cvra/CAN-USB-dongle/README.md

# CAN to USB adapter dongle

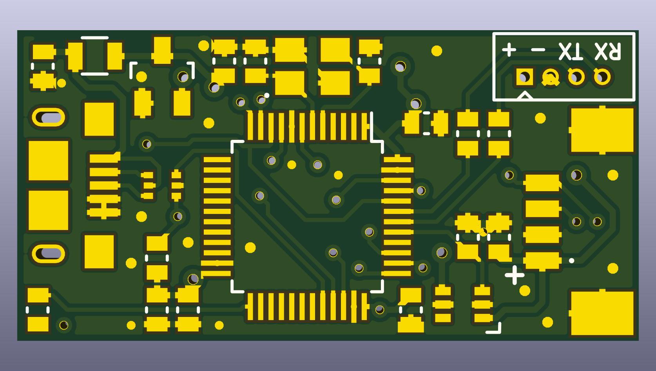
[picture p1: images/can-usb-dongle-front.jpg]
PCB front

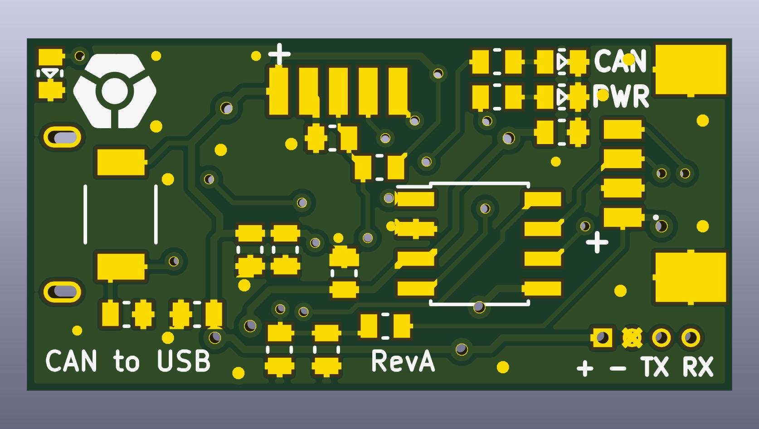
[picture p2: images/can-usb-dongle-back.jpg]
PCB back
