cvra/CAN-USB-dongle/BOM.ods

Total | 11.8679
number of boards | 7
Reference | Value | DigiKey part no. | QTY per board | Price (QTY=10) |  | QTY total | comment | Footprint
C2,C3,C4,C5,C9,C10,C13,C14,C16 | 100nF | 311-1088-1-ND | 9 | 0.0081 | 0.0729 | 63 |  | _std:_0603
C6 | 10nF | 311-1085-1-ND | 1 | 0.017 | 0.017 | 7 |  | _std:_0603
C7,C8 | 10pF | 399-1049-1-ND | 2 | 0.03 | 0.06 | 14 |  | _std:_0603
C11,C12,C15 | 1uF | 587-1242-1-ND | 3 | 0.041 | 0.123 | 21 |  | _std:_0603
C1 | 4.7uF | 311-1455-1-ND | 1 | 0.095 | 0.095 | 7 |  | _std:_0603
CONN1 | UART | WM1733-ND | 1 | 0.375 | 0.375 | 7 |  | _connectors:Molex-PicoBlade-4
CONN3 | MICRO_USB | 609-4616-1-ND | 1 | 0.386 | 0.386 | 7 |  | _connectors:_Micro-USB-AB-receptacle-SMT-th-no-slot
CONN4,CONN5 | CAN1 | WM7622CT-ND | 2 | 1.069 | 2.138 | 14 |  | _connectors:_Molex-PicoBlade-SMD-4
D1 | STATUS | 160-1436-1-ND | 1 | 0.24 | 0.24 | 7 | red | _std:_0603
D2 | CAN1 | 475-2831-1-ND | 1 | 0.35 | 0.35 | 7 | white | _std:_0603
D3 | V_BUS_PWR | 160-1435-1-ND | 1 | 0.24 | 0.24 | 7 | green | _std:_0603
F1 | Ih=500mA, It=1A | PICOSMDC050S-2CT-ND | 1 | 0.28 | 0.28 | 7 |  | Resistors_SMD:R_0805
R10,R11 | 100 | 311-100GRCT-ND | 2 | 0.008 | 0.016 | 14 |  | _std:_0603
R8 | 1.5k | 311-1.5KGRCT-ND | 1 | 0.011 | 0.011 | 7 |  | _std:_0603
R1,R2,R3,R4,R9 | 10k | 311-10.0KHRCT-ND | 5 | 0.01 | 0.05 | 35 |  | _std:_0603
R5 | 820 |  | 1 | 0.011 | 0.011 | 7 | STATUS | _std:_0603
R6 | 330 |  | 1 | 0.011 | 0.011 | 7 | CAN | _std:_0603
R7 | 680 |  | 1 | 0.011 | 0.011 | 7 | PWR | _std:_0603
SW1 | SW_PUSH | - | 1 | 0 | 0 | 7 | from ebay | _div:PushButtonSMD-5x3mm
U1 | STM32F302C8T | 497-14699-ND | 1 | 3.671 | 3.671 | 7 |  | Housings_QFP:LQFP-48_7x7mm_Pitch0.5mm
U2 | SN65HVD256 | 296-30093-1-ND | 1 | 1.276 | 1.276 | 7 |  | Housings_SOIC:SOIC-8_3.9x4.9mm_Pitch1.27mm
U3 | NUF2042XV6 | NUF2042XV6T1GOSCT-ND | 1 | 0.255 | 0.255 | 7 |  | _std:SOT-563_6-lead
U4 | MCP1700 | MCP1700T3302ETTCT-ND | 1 | 0.33 | 0.33 | 7 |  | Housings_SOT-23_SOT-143_TSOT-6:SOT-23
U5 | SiP32431 | SIP32431DR3-T1GE3CT-ND | 1 | 0.38 | 0.38 | 7 |  | Housings_SOT-23_SOT-143_TSOT-6:SC-70-6
X1 | 16MHz 10ppm | SER4069CT-ND | 1 | 0.469 | 0.469 | 7 |  | _div:_TSX-3225-SMD-XTAL
PCB | 2 layer 15x30mm |  | 1 | 1 | 1 | 7 |  | 10pcs à 10$ + shipping
Stencil |  |  | 1 | 0 | 0 | 7 |  | 10$ + shipping
