cvra/CAN-USB-dongle/can-usb-dongle-revC.pdf

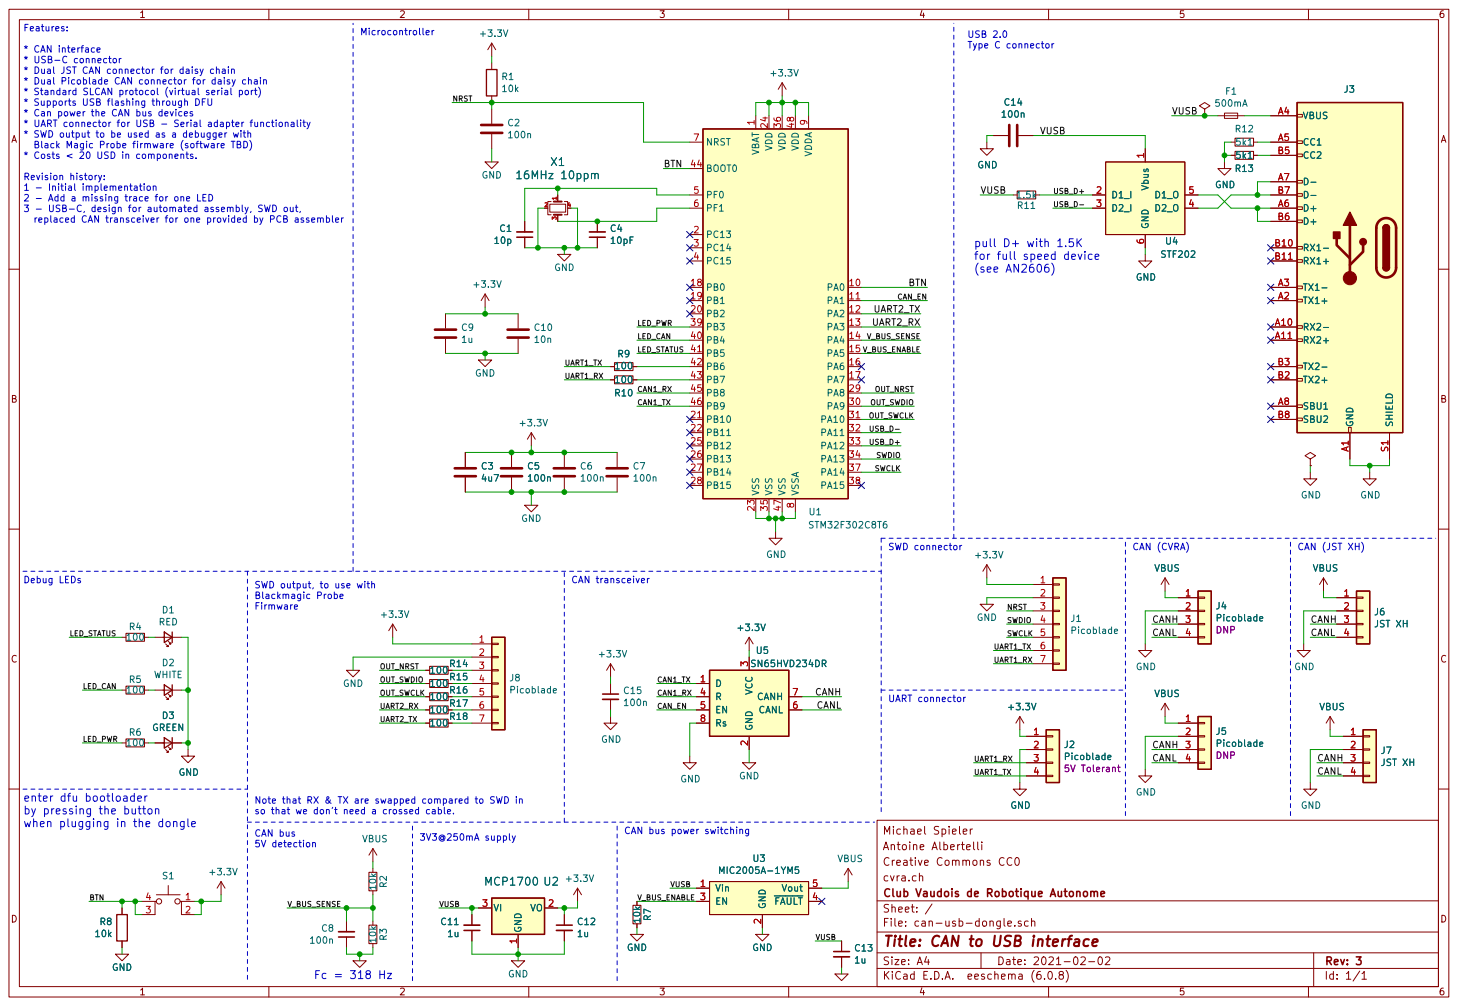
[picture p3: page 1]

* USB-C connector * Dual JST CAN connector for daisy chain

* Dual Picoblade CAN connector for daisy chain
* Standard SLCAN protocol (virtual serial port)
* Supports USB flashing through DFU
* Can power the CAN bus devices
* UART connector for USB - Serial adapter functionality
* SWD output to be used as a debugger with
Black Magic Probe firmware (software TBD)
* Costs < 20 USD in components.

1 PA0 10 PA1 11 PA2 12 PA3 13 PA4 14 PA5 15 PA6 16 PA7 17 PB0 18 PB1 19 PC13 2 PB2 20 PB10 21 PB11 22 VSS 23 VDD 24 PB12 25 PB13 26 PB14 27 PB15 28 PA8 29 PC14 3 PA9 30 PA10 31 PA11 32 PA12 33 PA13 34 VSS 35 VDD 36 PA14 37 PA15 38 PB3 39 PC15 4 PB4 40 PB5 41 PB6 42 PB7 43 BOOT0 44 PB8 45 PB9 46 VSS 47 VDD 48 PF0 5 PF1 6 NRST 7 VSSA

Revision history:
1 - Initial implementation
2 - Add a missing trace for one LED
3 - USB-C, design for automated assembly, SWD out,
replaced CAN transceiver for one provided by PCB assembler

for full speed device

Debug LEDs enter dfu bootloader by pressing the button

CAN (CVRA) CAN bus 5V detection SWD output, to use with

SWD connector Fc = 318 Hz

Note that RX & TX are swapped compared to SWD in

2 EN 3 ~{FAULT} 4 Vout 5 U3 MIC2005A-1YM5 GND

when plugging in the dongle

File: can-usb-dongle.sch Sheet: / Club Vaudois de Robotique Autonome

Id: 1/1 Title: CAN to USB interface
