cvra/CAN-USB-dongle/can-usb-dongle-revB.pdf

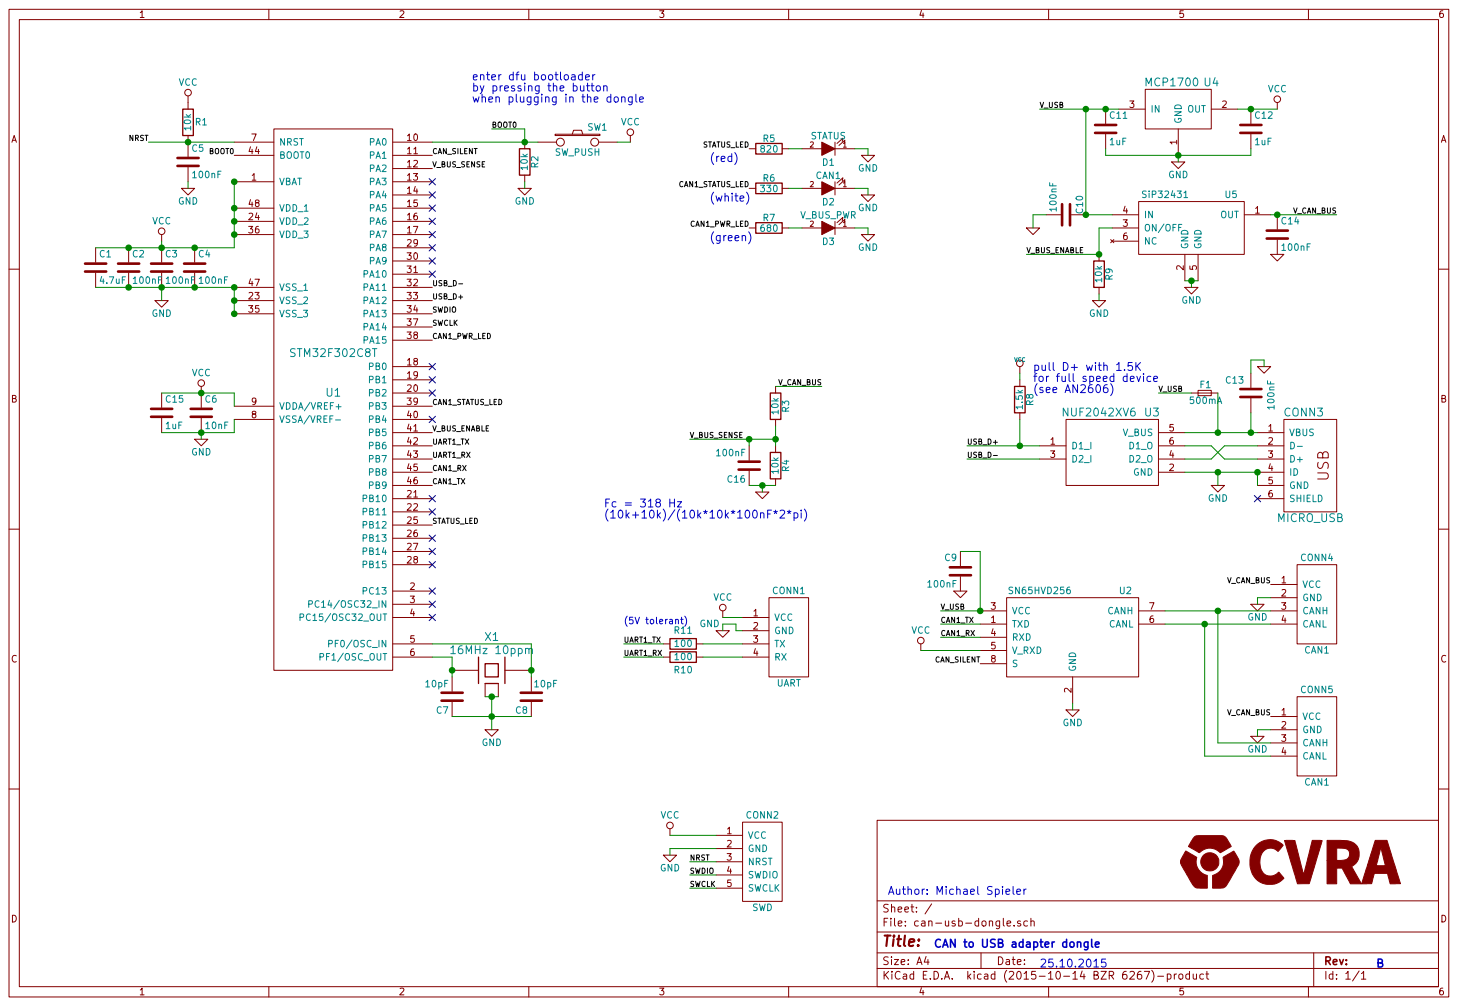
[picture p4: page 1]

enter dfu bootloader by pressing the button
CAN_SILENT UART1_RX UART1_TX
(white)

VCC pull D+ with 1.5K
for full speed device
MICRO_USB R8 1.5k

2 VCC 3 RXD 4 V_RXD 5 CANL 6 CANH 7 S

V_CAN_BUS GND CAN to USB adapter dongle

Author: Michael Spieler
File: can-usb-dongle.sch Sheet: /
Id: 1/1 Title:
