cvra/CAN-USB-dongle/can-usb-dongle.kicad_pcb

## KiCad design can-usb-dongle.kicad_pcb (2021-03-09)

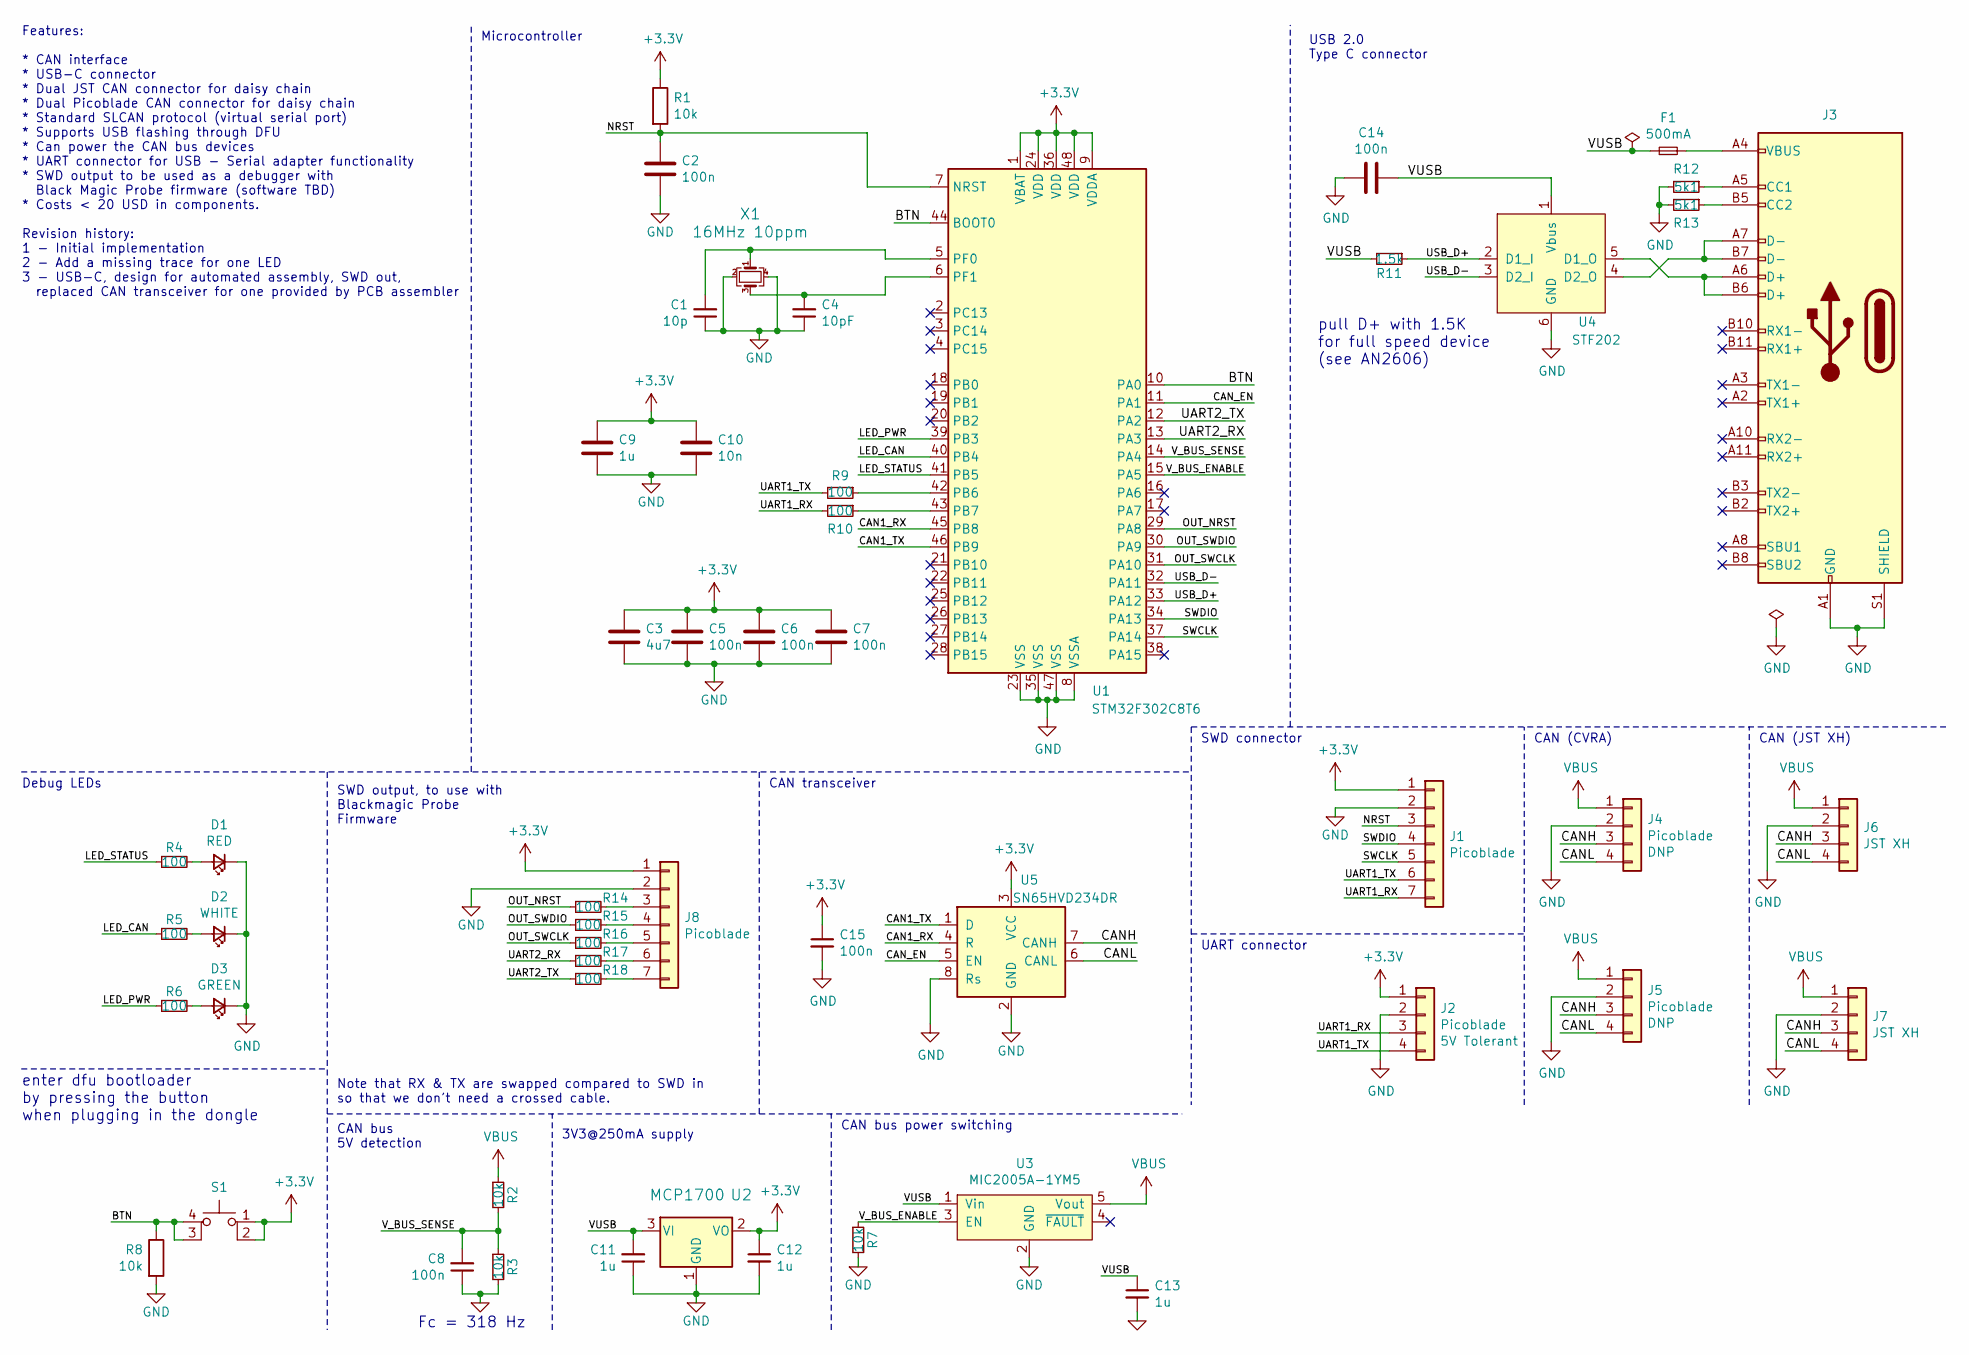
[picture p5: schematic can-usb-dongle.sch, CAN to USB interface]

Parts:
C1: 10p; C_0402_1005Metric; lcsc C1546
C2, C5, C6, C7, C8, C14, C15: 100n; C_0402_1005Metric; lcsc C1525
C3: 4u7; C_0402_1005Metric; lcsc C23733
C4: 10pF; C_0402_1005Metric; lcsc C1546
C9, C11, C12, C13: 1u; C_0402_1005Metric; lcsc C52923
C10: 10n; C_0402_1005Metric; lcsc C15195
D1: RED; C_0603_1608Metric; lcsc C72044
D2: WHITE; C_0603_1608Metric; lcsc C83955
D3: GREEN; C_0603_1608Metric; lcsc C72042
F1: 500mA; R_0805; lcsc C261942
J1, J8: Picoblade; Molex_PicoBlade_53261-0771_1x07-1MP_P1.25mm_Horizontal
J2: Picoblade; Molex_PicoBlade_53261-0471_1x04-1MP_P1.25mm_Horizontal; Tolerance 5V Tolerant
J3: XUNPU TYPEC-304S-ACP16; TYPEC-304S-ACP16; lcsc C720630
J4, J5: Picoblade; Molex_PicoBlade_53261-0471_1x04-1MP_P1.25mm_Horizontal
J6, J7: JST XH; JST_XH_S4B-XH-A-1_1x04_P2.50mm_Horizontal
R1, R2, R3, R7, R8: 10k; R_0402_1005Metric; lcsc C25744
R4, R5, R6, R9, R10, R14, R15, R16, R17, R18: 100; R_0402_1005Metric; lcsc C25076
R11: 1.5k; R_0402_1005Metric; lcsc C25867
R12, R13: 5k1; R_0402_1005Metric; lcsc C25905
S1: SW_MEC_5E; TS-1187A-B-A-B; lcsc C318884
U1: STM32F302C8T6; LQFP-48_7x7mm_P0.5mm; lcsc C90795
U2: MCP1700; SOT-23; LCSC C39051
U3: MIC2005A-1YM5; SOT-23-5; lcsc C81399
U4: STF202; TSOP-6_1.65x3.05mm_P0.95mm; lcsc C233431
U5: SN65HVD234DR; SOIC-8_3.9x4.9mm_P1.27mm; LCSC C99818
X1: 16MHz 10ppm; Crystal_SMD_TXC_7M-4Pin_3.2x2.5mm; LCSC C13738

Connections:
+3V3: C3.1, C5.1, C6.1, C7.1, C9.1, C10.1, C12.1, C15.1, J1.1, J2.1, J8.1, R1.1, S1.1, S1.2, U1.1 (VBAT), U1.9 (VDDA), U1.24 (VDD), U1.36 (VDD), U1.48 (VDD), U2.2 (VO), U5.3 (VCC)
/BTN: R8.1, S1.3 (K), S1.4 (A), U1.10 (PA0), U1.44 (BOOT0)
/CAN1_RX: U1.45 (PB8), U5.4 (R)
/CAN1_TX: U1.46 (PB9), U5.1 (D)
/CANH: J4.3, J5.3, J6.3, J7.3, U5.7 (CANH)
/CANL: J4.4, J5.4, J6.4, J7.4, U5.6 (CANL)
/CAN_EN: U1.11 (PA1), U5.5 (EN)
/LED_CAN: R5.1, U1.40 (PB4)
/LED_PWR: R6.1, U1.39 (PB3)
/LED_STATUS: R4.1, U1.41 (PB5)
/NRST: C2.1, J1.3, R1.2, U1.7 (NRST)
/OUT_NRST: R14.1, U1.29 (PA8)
/OUT_SWCLK: R16.1, U1.31 (PA10)
/OUT_SWDIO: R15.1, U1.30 (PA9)
/SWCLK: J1.5, U1.37 (PA14)
/SWDIO: J1.4, U1.34 (PA13)
/UART1_RX: J1.7, J2.3, R9.2
/UART1_TX: J1.6, J2.4, R10.2
/UART2_RX: R17.1, U1.13 (PA3)
/UART2_TX: R18.1, U1.12 (PA2)
/USB_D+: R11.1, U1.33 (PA12), U4.2 (D1_I)
/USB_D-: U1.32 (PA11), U4.3 (D2_I)
/VUSB: C11.2, C13.1, C14.1, F1.1, R11.2, U2.3 (VI), U3.1 (Vin), U4.1 (Vbus)
/V_BUS_ENABLE: R7.1, U1.15 (PA5), U3.3 (EN)
/V_BUS_SENSE: C8.2, R2.2, R3.1, U1.14 (PA4)
GND: C1.1, C2.2, C3.2, C4.1, C5.2, C6.2, C7.2, C8.1, C9.2, C10.2, C11.1, C12.2, C13.2, C14.2, C15.2, D1.1 (K), D2.1 (K), D3.1 (K), J1.2, J2.2, J3.A1 (GND), J3.A12 (GND), J3.B1 (GND), J3.B12 (GND), J3.S1 (SHIELD), J4.2, J5.2, J6.2, J7.2, J8.2, R3.2, R7.2, R8.2, R12.2, R13.2, U1.8 (VSSA), U1.23 (VSS), U1.35 (VSS), U1.47 (VSS), U2.1 (GND), U3.2 (GND), U4.6 (GND), U5.2 (GND), U5.8 (Rs), X1.2, X1.4
unnamed: C1.2, U1.5 (PF0), X1.1
unnamed: C4.2, U1.6 (PF1), X1.3
unnamed: D1.2 (A), R4.2
unnamed: D2.2 (A), R5.2
unnamed: D3.2 (A), R6.2
unnamed: F1.2, J3.A4 (VBUS), J3.A9 (VBUS), J3.B4 (VBUS), J3.B9 (VBUS)
unnamed: J3.A5 (CC1), R12.1
unnamed: J3.A6 (D+), J3.B6 (D+), U4.5 (D1_O)
unnamed: J3.A7 (D-), J3.B7 (D-), U4.4 (D2_O)
unnamed: J3.B5 (CC2), R13.1
unnamed: J8.3, R14.2
unnamed: J8.4, R15.2
unnamed: J8.5, R16.2
unnamed: J8.6, R17.2
unnamed: J8.7, R18.2
unnamed: R9.1, U1.43 (PB7)
unnamed: R10.1, U1.42 (PB6)
VBUS: J4.1, J5.1, J6.1, J7.1, R2.1, U3.5 (Vout)

Notes on the sheet:
enter dfu bootloader by pressing the button when plugging in the dongle
pull D+ with 1.5K for full speed device (see AN2606)
Fc = 318 Hz
Features: * CAN interface * USB-C connector * Dual JST CAN connector for daisy chain * Dual Picoblade CAN connector for daisy chain * Standard SLCAN protocol (virtual serial port) * Supports USB flashing through DFU * Can power the CAN bus devices * UART connector for USB - Serial adapter functiona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
CAN (CVRA)
CAN (JST XH)
3V3@250mA supply
CAN bus 5V detection
SWD connector
UART connector
CAN transceiver
USB 2.0 Type C connector
SWD output, to use with Blackmagic Probe Firmware
Microcontroller
Debug LEDs
CAN bus power switching
Note that RX & TX are swapped compared to SWD in so that we don't need a crossed cable.

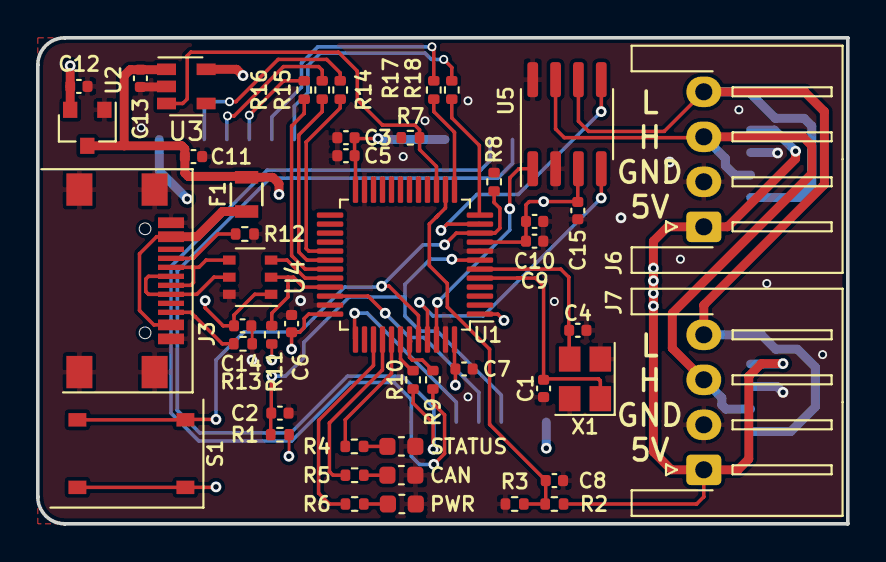
[picture p6: board can-usb-dongle.kicad_pcb from above]

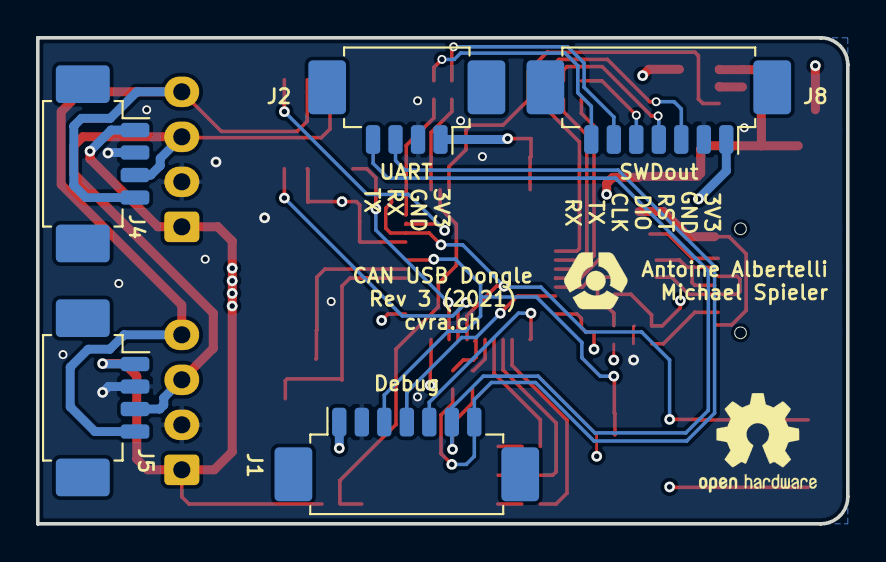
[picture p7: board can-usb-dongle.kicad_pcb from below]

Board: 4 copper layers, 45.0 x 27.0 mm, 52 parts (5 on the bottom side), 44 nets.
