cvra/CAN-USB-dongle/(commit log)

2015-05-24 Add kicad library submodule
2015-05-24 Start with schematic.
    [can-usb-dongle.sch]
2015-05-24 note differnt possible CAN transceivers.
    [can-usb-dongle.sch]
2015-06-30 Switch to STM32F3 LQFP48 with only 1 CAN interface.
    [can-usb-dongle.sch]
2015-08-19 Changes to reduce cost.
    [can-usb-dongle.sch]
2015-09-09 start assigning footprints.
    [can-usb-dongle.sch]
2015-09-30 Add V_BUS sense and LED, USB pull resistors.
    [can-usb-dongle.sch]
2015-09-30 Remove PWR LED.
    [can-usb-dongle.sch]
2015-09-30 Remove duplicate 1.5k USB D+ pullup.
    [can-usb-dongle.sch]
2015-10-02 USB protection, more capacitors.
    - Add NUF2042 ESD proctection for USB
    - Correct fuse placement
    - Add capacitors to CAN transceiver and SiP32431 switch.
    [can-usb-dongle.sch]
2015-10-02 Rearrange symbols.
    [can-usb-dongle.sch]
2015-10-19 Start with footrpint placement on PCB
    [can-usb-dongle.kicad_pcb, can-usb-dongle.sch]
2015-10-20 Most components placed.
    [can-usb-dongle.kicad_pcb, can-usb-dongle.sch]
2015-10-20 Connect CAN bus power LED to GPIO, update connector footprints.
    [can-usb-dongle.kicad_pcb, can-usb-dongle.sch]
2015-10-20 Change DRC minimal dimmensions
    [can-usb-dongle.kicad_pcb]
2015-10-20 PCB layer setting, correct edge cut layer
    [can-usb-dongle.kicad_pcb]
2015-10-21 Change pinout to optimize routing.
    [can-usb-dongle.kicad_pcb, can-usb-dongle.sch]
2015-10-21 All components roughly placed.
    [can-usb-dongle.kicad_pcb, can-usb-dongle.sch]
2015-10-21 Start routing
    [can-usb-dongle.kicad_pcb]
2015-10-22 Most traces fixed, need for optimization.
    [can-usb-dongle.kicad_pcb]
2015-10-22 optimize traces
    [can-usb-dongle.kicad_pcb]
2015-10-22 Better LED placement, change VCC routing
    [can-usb-dongle.kicad_pcb]
2015-10-22 Optimize VCC routing, redo power supply.
    [can-usb-dongle.kicad_pcb, can-usb-dongle.sch]
2015-10-22 Add GND fill zone, DRC check corrections
    [can-usb-dongle.kicad_pcb]
2015-10-23 Improve GND connection with vias
    [can-usb-dongle.kicad_pcb]
2015-10-23 Update kicad lib with missing footprints
2015-10-23 Add CVRA logo, silk screen text
    [can-usb-dongle.kicad_pcb]
2015-10-23 Change USB footprint back to slot version
    [can-usb-dongle.kicad_pcb]
2015-10-24 GND connection, tracks
    [can-usb-dongle.kicad_pcb]
2015-10-24 Start with bill of materials
    [BOM.ods]
2015-10-24 Modify silkscreen text
    [can-usb-dongle.kicad_pcb]
2015-10-24 Update footprints (USB, voltage regulator)
    [can-usb-dongle.kicad_pcb, can-usb-dongle.sch]
2015-10-24 Resolve GPIO conflict with JTAG pin
    V_BUS_ENABLE and CAN_SILENT were in conflict with JTAG output pins.
    They had to be moved because at boot time the output value cannot be guaranteed.
    [can-usb-dongle.kicad_pcb, can-usb-dongle.sch]
2015-10-24 Fix floating via
    [can-usb-dongle.kicad_pcb]
2015-10-24 Resolve JTAG pin conflict, add V_BUS_SENSE filter cap
    [can-usb-dongle.kicad_pcb, can-usb-dongle.sch]
2015-10-24 Fix silkscreen text
    [can-usb-dongle.kicad_pcb]
2015-10-24 Increase component dinstance on backside for handsoldering
    [can-usb-dongle.kicad_pcb, can-usb-dongle.sch]
2015-10-25 Select DigiKey components
    [BOM.ods]
2015-10-25 Add CVRA logo to schematic
    [can-usb-dongle.kicad_pcb, can-usb-dongle.sch]
2015-10-25 Add solder mask clearance, fix missing F.Paste at USB pads
    [can-usb-dongle.kicad_pcb]
2015-10-25 add 5% solder paste clearance
    [can-usb-dongle.kicad_pcb]
2015-10-25 Update schematic date
    [can-usb-dongle.sch]
2015-10-25 Add fabrication files
    [can-usb-dongle-B_Cu.gbl, can-usb-dongle-B_Mask.gbs, can-usb-dongle-B_Paste.gbp, can-usb-dongle-B_SilkS.gbo, can-usb-dongle-Edge_Cuts.gm1, can-usb-dongle-F_Cu.gtl, can-usb-dongle-F_Mask.gts, can-usb-dongle-F_Paste.gtp]
2015-10-25 Add pdf schematic
2015-11-09 Update kicad-lib
2015-11-09 Latest BOM version
    [BOM.ods]
2015-11-09 Add PCB images.
2015-11-22 Update LED resistor values.
    [can-usb-dongle.sch]
2015-11-22 Start RevB, add missing STATUS LED track
    [can-usb-dongle.kicad_pcb, can-usb-dongle.sch]
2015-11-23 Colored schematic PDF.
2021-02-19 Change power switch for one in stock
    [can-usb-dongle.kicad_pcb, can-usb-dongle.sch]
2021-03-01 Finalize routing, ready for review
    [can-usb-dongle-B_Cu.gbl, can-usb-dongle-B_Mask.gbs, can-usb-dongle-B_Paste.gbp, can-usb-dongle-B_SilkS.gbo, can-usb-dongle-Edge_Cuts.gm1, can-usb-dongle-F_Cu.gtl, can-usb-dongle-F_Mask.gts, can-usb-dongle-F_Paste.gtp]
2021-03-07 Address comments by nuft@
    * Document the change of CAN transceiver
    * Swap RX/TX on SWD output
    * Add silkscreen describing led function
    * fix silkscreen text size
    [can-usb-dongle.kicad_pcb, can-usb-dongle.sch]
2021-03-09 Put the SWDout UART on UART2
    [can-usb-dongle.kicad_pcb, can-usb-dongle.sch]
2021-03-09 fix silkscreen
    [can-usb-dongle.kicad_pcb]
2021-03-14 Add gerber files for gen3
    [can-usb-dongle-B_Cu.gbl, can-usb-dongle-B_Mask.gbs, can-usb-dongle-B_Paste.gbp, can-usb-dongle-B_SilkS.gbo, can-usb-dongle-Edge_Cuts.gm1, can-usb-dongle-F_Cu.gtl, can-usb-dongle-F_Mask.gts, can-usb-dongle-F_Paste.gtp]
2023-01-08 Add schematics of old CAN USB dongles
