cvra/CAN-USB-dongle/(notices)

Notices in the files:
can-usb-dongle.sch:
Creative Commons CC0
